zagor/tinytemp/(commit log)

2017-01-07 Added temperature correction value
    [tinytemp.ino]
2018-06-01 Update battery life
